SFUSatClub/KiCad-Lib/(threads)

Thread 2 (2017-05-18):

Add PC104 connectors

TobiNakamura, 2017-05-18:
The smaller 16 bit connector should be enough

TobiNakamura, 2017-05-31:
committed 6d26c2590282e700a34f9d8f6eba6b7e899c2796

Alenux55, 2017-06-01:
Looks like the rows are reversed compared to the standard:
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

Further, not a big deal, but can we change the pad diameter from **1.7272 mm** to **1.72 mm**? Numbers come from [this document](https://www.pcb-3d.com/knowledge-base/pth-dimensions/) using **Level A** and minimum hole diameter **1.02 mm**

Alenux55, 2017-06-02:
Updated the connector in commit [63ce77d](https://github.com/SFUSatClub/KiCad-Lib/commit/63ce77d67ed47e621efd1c700e57982c8e002d00)

Closed 2017-06-02.

Thread 3 (2017-05-18):

Add PC104 PTH

TobiNakamura, 2017-05-18:
Add mechanical plated through holes that conforms with PC104

TobiNakamura, 2017-05-31:
committed 48d65dc027d8708aceec9a7ec8f20d58987fb4a8

Alenux55, 2017-06-01:
Hole diameter and pad diameter look good
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

Closed 2017-06-01.

Thread 9 (2017-06-02):

Check footprint Socket_Strip_Straight_2x05

Alenux55, 2017-06-02:
Used the following document: [https://drawings-pdf.s3.amazonaws.com/11091.pdf](https://drawings-pdf.s3.amazonaws.com/11091.pdf)

TobiNakamura, 2017-06-02:
Checked layout for DO5-ST-BK. Also checked against figure 4 of CC debugger cable layout.
 (http://www.ti.com/lit/ug/swru197h/swru197h.pdf)

Closed 2017-06-02.

Thread 11 (2017-06-04):

Adjust footprint of capacitors

liquiddandruff, 2017-06-04:
From yesterday's assembly, the distance between each pad for the capacitors we used seems a bit too far; perhaps could be adjusted slightly (closer) for future revision.

liquiddandruff, 2017-06-04:
Oops; wrong repository lol

Closed 2017-06-04.

Thread 13 (2017-06-09):

Finalize SINGLE_0402

Alenux55, 2017-06-09:
On the F.Fab layer of SINGLE_0402, put two dots representing the centers of the pads of the 0402 component to connect to (yellow dots in following photo)
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

Also, what shape do we want to use?

Alenux55, 2017-07-28:
Looks good in 2a479b9; works well for [CubeSat-Radio Iteration 2](https://github.com/SFUSatClub/CubeSat-Radio/tree/Rev_2):
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

Closed 2017-07-28.

Thread 14 (2017-06-30):

0433BM15A0001 Pad spacing too wide

TobiNakamura, 2017-06-30:
Not enough of the pad and solder paste reaches the underside of component, making placement difficult and reducing yield.
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

Alenux55, 2017-07-28:
Using a [TDK component](https://www.digikey.ca/product-detail/en/tdk-corporation/DEA202450BT-7210A1/445-15654-2-ND/4321985) as reference; pads are closer.
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

Alenux55, 2017-07-28:
Fixed in 2cb76bd

Closed 2017-07-28.

Thread 15 (2017-07-04):

Check MML09211HT1

Alenux55, 2017-07-04:
Datasheet: [http://www.nxp.com/docs/en/data-sheet/MML09211H.pdf](http://www.nxp.com/docs/en/data-sheet/MML09211H.pdf)
Symbol: MML09211H
Footprint: 8-VFDFN

Alenux55, 2017-07-28:
Check the via size against PCBway specs

Alenux55, 2017-07-28:
Fixed in ee9866f

Closed 2017-07-28.

Thread 17 (2017-07-07):

Check RF6886

Alenux55, 2017-07-07:
Datasheet: [http://www.planetec.com/product/datasheet/RF6886.pdf](http://www.planetec.com/product/datasheet/RF6886.pdf)
Symbol: RF6886
Footprint: QFN-24

Alenux55, 2017-07-28:
Correct:
- Pad spacing is correct
- Pad locations are correct
- Pad sizes are correct
- Solder mask clearance is correct

Incorrect:
- Paste mask is different
    - Datasheet specifies non-constant paste mask clearance:
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
    - Rather than making a custom paste mask for each outer pin, just make the area of paste the same so we can use the global paste mask value:
        0.234 mm\*0.475 mm = **0.11115 mm<sup>2</sup>** ->
        (0.260 - x)\*(0.528 - x) = 0.11115 ->
        x<sup>2</sup> - 0.788x + 0.13728 = 0.11115 ->
        x<sup>2</sup> - 0.788x + 0.02613 = 0 -> Quadratic forumla... ->
        x = 0.75331 mm, **0.03469 mm** ->
    -So we'll choose a clearance of **0.035 mm** to give an area of **0.110925 <sup>mm</sup>**

Alenux55, 2017-07-28:
Fixed in 2a479b9

Alenux55, 2017-07-28:
Note: clearance should be **0.0175 mm** instead of **0.035 mm**; the clearance is *around* the pad, while the value I calculated is *total width increase*

Closed 2017-07-28.

Thread 20 (2017-07-07):

Check SN74LVC1G17DBVR

Alenux55, 2017-07-07:
Datasheet: [http://www.ti.com/lit/ds/symlink/sn74lvc1g17.pdf](http://www.ti.com/lit/ds/symlink/sn74lvc1g17.pdf)
Symbol: SN74LVC1G17
Footprint: SOT_23_5

TobiNakamura, 2017-07-28:
Made pin 1 indicator smaller.

Closed 2017-07-28.

Thread 24 (2017-08-12):

n channel fet footprint outline

TobiNakamura, 2017-08-12:
outline of sot23 is a rectangle that is too large. adjust to show actual package outline

Thread 25 (2017-08-12):

TSSOP-8 needs better pin 1

TobiNakamura, 2017-08-12:
Currently the pin 1 indicator is a line next to pad 1. Make that a circle to conform with other footprints.

Thread 31 (2018-02-01):

Check JSLINTER-39x26 footprint

TobiNakamura, 2018-02-01:

TobiNakamura, 2018-02-23:
Sch Lib: JSLINTER
Footprint: SFUSat:JSLINTER-39x26
Product page: https://www.aliexpress.com/store/product/JSLINTER-150pcs-Cheap-Solar-Cell-Polycrystalline-DIY-Solar-Panel-Small-Battey-Charger-0-5V-0-18W/213231_32791938913.html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

Closed 2018-03-30.

Thread 37 (2018-02-19):

Check SMM4F5 footprint and symbol

TobiNakamura, 2018-02-19:

TobiNakamura, 2018-02-23:
Sch Lib: SMM4F5.0A-TR
Footprint: SFUSat:SMM4F
Datasheet: http://www.st.com/content/ccc/resource/technical/document/datasheet/5d/b3/40/b8/ac/6c/49/a2/CD00178940.pdf/files/CD00178940.pdf/jcr:content/translations/en.CD0017894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

JakubStacho, 2018-03-02:
Fixed issue. Changed K to C in the symbol.

25c188dd26142ba08cfe6034f8f194ebabf3b6d9

Closed 2018-03-02.

Thread 41 (2018-03-05):

Check OEM719 Component and Footprint

TobiNakamura, 2018-03-05:
http://docs.novatel.com/oem7/Content/PDFs/OEM7_Installation_Operation_Manual.pdf

See A.6 of op. manual for IO
See A.2 of op. manual for dimentions. Note! the GPS board is mounting face down onto the footprint, so everything has to be mirrored from the diagrams in the op. manual.

Closed 2018-03-30.

Thread 42 (2018-03-17):

Check SKY13345-368LF

Alenux55, 2018-03-17:
Datasheet: http://www.skyworksinc.com/uploads/documents/201194D.pdf
Footprint: 12-UFQFN-PAD
Symbol: SKY13345-368LF

JakubStacho, 2018-04-02:
These look good. I noticed that our symbol and footprint have a pin 13 (GND) in the middle of the chip however the datasheet only has pins up to 12. Is that alright?

Closed 2018-04-20.

Thread 45 (2018-03-30):

Check LM3480

TobiNakamura, 2018-03-30:
In SFUSat-Power library: LM3480
Footprint: SOT-23-3

JakubStacho, 2018-04-02:
The footprint for this component looks good.

Closed 2018-04-02.

Thread 50 (2018-03-31):

Check 5V regulation ICs

TobiNakamura, 2018-03-31:
Both in the CubeSat-Radio 5V regulator schematic
Components: [TPS62175DQCR](http://www.ti.com/lit/ds/symlink/tps62177.pdf), [TPS71750DSER](http://www.ti.com/lit/ds/symlink/tps717.pdf)
Footprint: SFUSat:WSON-10, SFUSat:WSON-6

TobiNakamura, 2018-04-30:
WSON-6 is the 1.5x1.5mm version (DSE)
Both look good

Closed 2018-04-30.

Thread 53 (2018-04-25):

SFUSat:TSSOP-16 Needs better pin 1 indicator

TobiNakamura, 2018-04-25:
Its currently too small to see
