SFUSatClub/KiCad-Lib/(commit log)

2017-05-10 fixed 2N7002DW schematic pin assignment
2017-05-10 added SPST tactile switch, added standard R and C footprints
2017-05-10 added 0603 led footprint
2017-05-10 added test point footprints
2017-05-11 added SPST schematic
2017-05-11 added flash, 1.2v regulator, watchdog schematic components
2017-05-12 Horizontally mirrored 'Socket_Strip_Straight_2x05
    On Rev. 1, the connector was mirrored, so we had to put it on the opposite side of the board
2017-05-21 added PC104 plated hole symbol and footprint
2017-05-22 added vertically mounted through hole SMA
2017-05-22 Updated README.md for KiCad-Lib
2017-05-22 Updated tact switch
2017-05-22 added switch datasheet
2017-05-25 Modified pin header footprints to have larger holes/pads
2017-05-27 added fiducial footprint
2017-05-28 Added components
    -Updated CC1101-Q1 symbol and added footprint\n-Added a symbol and footprint for a single 0402 pad for SMA usage
2017-05-28 Added solder paste apertures
2017-05-28 Removed old pin header footprints
2017-05-31 fixed 2N7000 pin
2017-06-02 Updated debug connector with shroud
2017-06-02 Updated debug connector again because I'm a perfectionist
    Sorry
2017-06-02 Updated PC104-8bit connector
2017-06-04 Updated 0402 cap to 0.225mm pad edge-to-center spacing. Datasheet says 0.3mm which is insane, previously was 0.25mm which was a little hard to place accurately.
2017-06-09 Updated CC1101-Q1 soldermask
    Changed from 0.07 mm to 0.06 mm to icnrease webbing above 4 mil
2017-06-30 Fixed up MCU footprint, added all pins.
2017-07-07 Fixed PC104 connector
2017-07-07 Fixed PC104 connector again
2017-07-07 Added PWM DAC
2017-07-07 Added level shifter for DAC PWM
2017-07-18 Added R_0402 silkscreen refdes
2017-07-18 Undid changes to L, R, and C 0402 footprints
    Didn't realize I ad references layer turned off
2017-07-18 Added VIA-0.6mm
2017-07-19 Added L_0603 and mouse-bite-2mm-slot
2017-07-21 copied footprint from kicad TSSOP library
2017-07-24 added coilcraft inductor footprint
2017-07-24 Added B and C case tantalum capacitor footprints
2017-07-25 Fixed duplicate pin B10 on 104 connector, added USB port and crystal
2017-07-25 Brougt in JTAG, Xtal, tact switch, test point, USB component footprints from backup
2017-07-25 Added JTAG and flash schematic components from backup
2017-07-28 Updated QFN-24
    -Added vias on ground pad
    -Updated paste mask to have same area as in datasheet
2017-07-28 pin 1 indicator on SOT_23_5 is smaller
2017-07-28 changed via size to 0.3mm
2017-07-30 Added trimpot footprint and schematic symbol. Bourns T33 series
2017-07-31 added outline to SOT-223, outline and paste layer to mini USB footprint
2017-09-03 Added bq771601 bq40z50-R1 SPV1040 charging and battery managment IC schematic symbols. A new power schematic library was made to house the 3 ICs. Moving forward, specialized ICs should go into their 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
2017-12-25 Added step-up support and 3D models for vertical TH SMA and PC/104 connectors. See README for details about exporting 3D models of the board and the kicad support required to accomplish that. Reposit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
2018-01-05 Added TSSOP-8 3mm, SOT505-1
    NOT the same as a normal TSSOP, it's narrower. For STLM75 temp sensor
2018-01-05 Added STLM75 temp sensor component
2018-01-08 Added DIP switch
2018-01-09 Fixed Taxt_Sw_SMD_v2
    Pins 1-2, 3-4 are diagonal from each other, allowing footprint to connect correctly when using a standard schematic symbol (which uses pins 1 & 2)
2018-01-09 jtag connector
2018-01-12 Added 10 pin JTAG component
2018-01-17 Added USB-B connector, 3.2mm DC barrel jack
    Footprints and symbols (if applicable)
2018-01-23 Updated 10 pin JTAG footprint and component
    Added TRST pin which is required for JTAG to succeed. Widened silk on footprint to account for header shroud size
2018-01-23 Added BQ25703ARSNT and updated CC1101-Q1 footprint
2018-01-27 Updated CC1101-Q1 footprint
    Using via locations rather than placing the vias so that it is parametric board-to-board
2018-01-31 updated supercap footprint to handle 470uF or 330uF
2018-02-01 Added JSLINTER PV cells, MOLEX FFC connector, Photodiode. These all need to be verified.
2018-02-04 Added ADG728 symbol and footprint
2018-02-05 Dedicated libraries and Python
    Created individual symbol and footprint libraries for common components (i.e. capacitors, resistors, etc.)
2018-02-05 Added CSD17551Q3A
    Still need to add its footprint
2018-02-06 Added csd17551q3a symbol and footprint
    Also updated kicadLibPop.py to support any component; puts others into SFUSat.lib
2018-02-06 Updated kicadLibPop.py to give other components reference designator 'U'
2018-02-09 Added more caps and resistors for BMS
2018-02-11 Added kicad project template. Currently only the basic template exits but more can be made in the future such as a PC104 template.
    [SFUSat.kicad_pcb, SFUSat.sch]
2018-02-12 Added BOM configuration file
2018-02-12 Added aluminum cap footprint
    Also updated tantalum capacitor symbol
2018-02-13 Added tantalum capacitor and P-MOSFET
2018-02-13 Added battery balance IC: BQ29209
2018-02-14 Added 2mm drill dia PTH
2018-02-14 Copied Battery symbol to SFUSat-Power lib
2018-02-17 added 3d models for diode and FFC connector
2018-02-18 Added 8-PowerWDFN
    Also updated the script to handle whitespace and removed the CSD17551Q3A footprint
2018-02-18 Added more generic footprints and symbols
2018-02-18 Changed footprint 'SOT-23' to 'SOT-23-3'
2018-02-18 Added components for MPPT boost circuit
2018-02-18 added 357k resistor
2018-02-19 Added MUX and FFC symbols. Moved from panel-connector-cache. Dont know how this wasnt commited to the SFUSat library before.
2018-02-20 Re-added components from BMS that were removed
2018-02-21 moved SMM diode from cache to SFUSat
2018-02-23 Added GPS symbol and footprint.
2018-02-25 Schematic symbol for OEM719
2018-02-25 added MCX footprint and 3D model for MCX jack and GPS antenna
2018-02-28 Updated SMM4F5 symbol and added UFL-R-SMT-1 Coaxial Connector footprint
2018-03-01 Updated SMM4F5 symbol and added UFL-R-SMT-1 footprint
2018-03-02 Added footprint for FUL-R-SMT-1 Coaxial Connector. Also updated SMM4F5 symbol.
2018-03-03 added better pc104 backplane connector model
2018-03-04 OEM719 footprint had to be mirrored from the OEM manual
2018-03-04 reduced mounting hole plating
2018-03-05 fixed RF6886 NC to GND
2018-03-09 Added VDFN-8 footprint
2018-03-10 Fixed encoding issue and added some passives. utf-8 decode error was thrown due to the degree symbol in the temperature field. Passed error='replace' to file open function in readFile()
2018-03-10 added 3d models for B3B 3pos connector
2018-03-10 Re-added MOSFETs
2018-03-11 added deployment switch
2018-03-11 fixed PC104 pin 9b to 9B
2018-03-17 Updated SOT-223 name
    Generic name instead of part no. since it's a standard footprint
2018-03-25 Power Distribution Board Components
2018-03-25 load components for RF power supply
2018-03-30 Updated PESD5Zx footprint
2018-03-30 Removed pre-defined vias from RF6886 footprint
2018-03-30 Added PA tantalum capacitors
2018-03-31 added lms3635 to SFUSat-Power library
2018-03-31 added TPS563219 to SFUSat-Power library
2018-03-31 added tps2296 to SFUSat-Power library
2018-03-31 added WSON-10 footprint
2018-03-31 added WSON-6 footprint
2018-03-31 added inductor footprints
2018-04-01 added 1x2 and 1x3 connector symbol to SFUSat
2018-04-01 Fixed mask clearance on TSSOP-8 505
    Now 0.08mm, looks reasonable to me
2018-04-06 Fixed Switch Schematic and Inductor
    Fixed an issue with incorrectly labeled pins on the switching IC
    TPS22964xC
2018-04-09 Updated pin 1 marker on TSSOP-8_4.4x3mm_Pitch0.65mm.kicad_mod
2018-04-10 Added 1 mm diameter test point
2018-04-18 Multiple updates for RF board
    Added inverter, fixed ref des on some components, new pot
2018-04-18 Updated inverter footprint
    Made the courtyard smaller
2018-04-22 added 2.45mm pitch jumper and model
2018-04-27 Update Inductor Footprint for 3.3V and include new Demux for 1.6A
2018-04-27 made pin 1 indicator larger
2018-04-29 Added new footprints for connectors to the Antenna Feed board.
2018-05-04 Fixed schematic symbols of CSD17551Q3A and CSD25402Q3A to include pad 9 and Fixes #8 and Fixes #14
2018-05-04 fixed DMP3035SFG-7 symbol and added new footprint for said component
2018-05-10 Fix SS-3GLPD switch solder terminal spacing
2018-05-10 Move pads closer together on C_TANT_2917 footprint
2018-05-11 added mux schematic components
2018-05-12 simplified footprint polygon
2018-05-12 accidently deleted mosfet changes in merge
2018-05-15 Added assembly drawing info to RF components
    L_0603, L_1606, SLF6045, SLF7045, 12-UFQFN-PAD, 8-VFDFN, BMI-S-205-F, LED_0603, LMS3635AQRNLTQ1, L_0603, NX3225GA, PC104-8bit, QFN-16_650PM QFN-24, SOT_23_5, Socket_Strip_Straight_2x05, TSSOP-16, U_0805-6, WSON-10
2018-05-16 added 73.2k 0402 resistor
2018-05-16 added 1.62k resistor
2018-05-30 added 3mm NPTH
2018-06-02 1.75mm NPTH
2018-06-11 Updated component assembly drawing layers
    LMS3635AQRNLTQ1,QFN-24,CC1101-Q1,SLF6045,SLF7045,8-VFDFN,NX3225GA,SOT_23_5,QFN-16_650P,LED_0603,U_0805-6,Socket_Strip_Straight_2x05,PC104-8bit,WSON-6,WSON-10,TSSOP-16,SMA-Vert-TH
2018-06-11 Added courtyards to some components
    SLF6045,SLF7045,NX3225GA,QFN-16_650P,8-VFDFN,WSON-6,SOT_23_5,U_0805-6,PC104-8bit,Socket_Strip_Straight_2x05
2019-03-15 Add TE0725-03 FPGA symbol and footprint
